bhavesh1321/g12-scissor-conveyor/SimScale/results/simscale_displacement.png

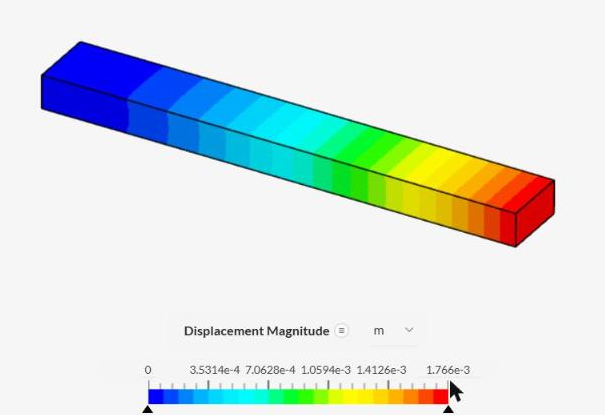
SimScale/results/simscale_displacement.png
