bhavesh1321/g12-scissor-conveyor/SimScale/results/simscale_von_mises.png

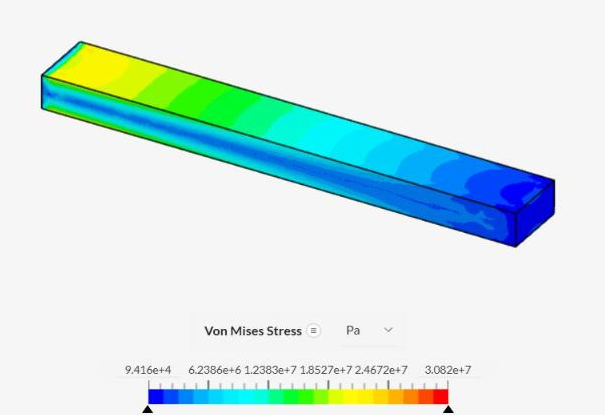
SimScale/results/simscale_von_mises.png
