bhavesh1321/g12-scissor-conveyor/Documentation/Conveyor_Project_Report_G12.docx

SCISSOR-EXPANDING BELT CONVEYOR FOR HARVEST FIELDS
(WITH MULTI-PLY AGRICULTURAL PVC CONVEYOR BELTING)

A project report submitted to

Dr. Sakthivel G

School of Mechanical Engineering

In partial fulfilment of the requirements for the course of

Agriculture Automation

In

B.Tech. Mechatronics and Automation

Group 12 | Final Project Review

Team Members:

Bhavesh A — 24BMH1048

Santhosh Kumar M — 24BMH1005

Monish K — 24BMH1001

Mithun Shankar M — 24BMH1053

Date of Submission: 21st October 2026

# ABSTRACT

This report presents the design of a scissor-expanding conveyor equipped with 2-ply food-grade agricultural PVC belting, developed to move harvested products such as banana bunches, jackfruit and coconut, each weighing up to 50 kg, from the field row to the collection vehicle. The conveyor is built as three wheeled aluminium A-frames (Head / drive, Centre, and Tail / tension) joined on each side by a lazy-tong scissor of 8 bays (16 links per side, 32 links in total) that sits on top of the A-frames. Pulling the end frames apart opens the unit to 3840 mm between end frames (4750 mm overall including the motor block) for carrying produce; pushing them together closes it to 2160 mm (3070 mm overall) for transport between fields, a change of 1680 mm or about 44 %. A flat 2-ply PVC belt with a woven polyester carcass rides on cross-beams at the scissor top nodes, so the belt stays supported at every length; this removes both the unsupported span of the earlier hinge-fold concept and the produce pinching associated with open metal mesh. The design has been taken through four CAD revisions (A to D). Revision D was rebuilt in CadQuery from the photographed prototype and passes a geometric fold check with no unintended overlaps at four bay pitches (480, 410, 340 and 270 mm). Eleven hand calculations (belt carcass and finger span, support fingers, finger beam, drive shaft, leg buckling, drive chain, scissor links and pins, and tip-over stability) all meet their criteria, but they were carried out on the revision C model and have not yet been re-run on revision D. A single plug-in worm gearmotor of at least 358 W at 26.2 rpm, fitted at the head drum, is sized to drive the full 200 kg payload. The aluminium A-frames and scissor links of the prototype are built; the belt, drive and control box are not yet fitted. Finite-element studies, the re-run of the calculations on revision D, a priced bill of materials, the load tests and the incline option remain to be done.

# INTRODUCTION

Harvesting tree and row crops such as banana, jackfruit and coconut still depends heavily on manual carrying once the produce is cut. A single bunch or fruit can weigh up to 50 kg, and carrying it by hand over even a short distance from the row to the waiting vehicle is slow, physically demanding, and a frequent cause of bruising, a problem also reported in studies of cableway-based haulage, where the hanging load swings against fixed structures along the line. A belt conveyor long enough to cover a useful span, around four metres, would remove most of this hand carrying, but a rigid conveyor of that length is awkward to move between fields and difficult to store between harvests.

This project addresses that conflict directly: the same frame needs to be long enough to be useful in the field and short enough to be convenient to move and store. The approach taken is a modular scissor-expanding architecture built from three wheeled aluminium A-frames (Head drive frame, Centre frame, and Tail tension frame). Between adjacent frames, a lazy-tong scissor on each side (4 bays per span, 8 bays and 16 links per side in total) sits on top of the A-frames, so that all eight bays open and close together as the end frames are pulled apart or pushed together. A flat, flexible multi-ply food-grade PVC belt (4 mm thick, 2-ply woven polyester carcass) rides on cross-beams at the scissor top nodes and carries the produce. Replacing open metal mesh with a continuous, smooth belt avoids bruising, skin puncture and pinching of delicate produce such as bananas and jackfruit, resists crop sap and moisture, allows washdown, and removes about 20 kg of belt tare mass (57.7 kg for the mesh against 38.0 kg for the PVC belt, on the revision C estimate). The project has been reviewed twice before; this report covers the final review and reports the concept up to revision D, the prototype built so far, and the work still pending.

# OBJECTIVES

- Change the working length of a single frame without disassembly: the conveyor must expand to 3840 mm between end frames for use in the field, and collapse to 2160 mm for moving between fields and for storage (bay pitch 480 mm to 270 mm), using the same frame and flexible PVC belt throughout.
- Carry a realistic field payload at a workable speed: the conveyor must move four items of up to 50 kg each — 200 kg total — along the belt at 0.20 m/s, with every structural and mechanical check meeting or exceeding its design criterion at that load.
- Drive the full load from a single plug-in motor: one worm gearmotor of at least 358 W at 26.2 rpm (390 W / 0.55 kW rated), fitted at the head drum, must be able to run the complete 200 kg line on its own.

# METHODOLOGY

Literature Review and Concept Generation

Existing approaches to moving harvested produce were reviewed before settling on the scissor-frame concept. A foldable conveying arm used on sugarcane harvesters (Liu H. et al., 2015) folds only for road travel and is built into the harvester, not a stand-alone unit. A review of banana post-harvest handling (Guo et al., Agronomy, 2020) covers cableway, manual and animal haulage, all of which either need a fixed line or leave the bunch swinging and exposed to bruising. A banana bunch transporter (Li et al., Agriculture, 2024) lifts and fixes a single bunch at a time rather than running a continuous belt. A patented expandable powered conveyor (Best et al., US Patent 5632371) uses lazy-tong scissor trusses to carry powered rollers, but is built for cartons riding on rollers and does not support a soft, heavy item resting between rollers. None of these gave a portable conveyor that keeps a flexible agricultural belt fully supported while the frame length itself changes by about 44 %, which is the gap this project’s concept is built to close.

CAD Modelling and Assembly

The concept went through four CAD revisions. Revisions A to C were modelled in SolidWorks (revision C as a full assembly with a motion study); revision D, the current model, was rebuilt in CadQuery (OpenCASCADE) with Python scripts and exported as STEP files, so that it matches the prototype photographed on site. The revision D model has 223 parts in the working position (215 in the fold-check model, which leaves out the belt and the other parts that are not checked) and is structured around three A-frames and a lazy-tong scissor of 8 bays per side with 620 mm links:
1. Head frame (x = 0): carries the Ø25 mm drive shaft and drum with two 36T sprockets, the plug-in worm gearmotor and coupling, and the sprocket guards.
2. Centre frame (mid-span): an A-frame that takes the load at the middle of the deck and carries the belt return supports.
3. Tail frame (end of the span): carries the tail drum and shaft, and the take-up bearings (UCT205 blocks with M16 drawbolts, 80 mm take-up travel).
Between the Head and Centre frames, and between the Centre and Tail frames, a scissor of 4 bays per side connects the span, giving 8 bays and 16 links per side (32 links in total) of Al 6082-T6 flat bar 30 × 8 mm, 620 mm between pivot pins. The scissors sit on top of the A-frames, as built. Cross-beams of RHS 80 × 40 × 3 mm at the top nodes (6 plus 1 at the centre) support the PVC belt throughout the 1680 mm stroke. The A-frame legs (splayed 6°, about 1043 mm) and lower rails are Al 6063-T5 RHS 40 × 40 × 3 mm. Smooth, closed aluminium box sections were chosen over open slotted profiles because they have no grooves to trap mud, fruit pulp or crop juice, are easy to wash down, and are stiff in bending and torsion.

Motion Study and Clash Verification

Revision C was checked with a SolidWorks motion study that drove the bay pitch from 480 mm to 270 mm and checked the assembly for interference at eight positions; it showed no clash. That model has since been replaced by revision D, which is checked geometrically instead: the revision D model is built at four bay pitches (480, 410, 340 and 270 mm) and tested for overlaps between parts, with 0 unintended overlaps at all four. This is a geometric check only; no motion study has been run on revision D.

Hand Calculations

Eleven hand calculations were carried out covering the conveyor belt carcass tensile strength and transverse finger span, the support fingers (yield and tip deflection), the finger beam (yield and deflection), leg buckling, the drive chain, the drive shaft, scissor link buckling, scissor pin shear, and tip-over stability under a lateral load. Loads were taken from the 50 kg item mass with a 1.5 impact factor (736 N per item), the revision C CAD frame and drive mass of 322.9 kg, and a belt mass of 38.0 kg (27.3 kg PVC belt sheet + 10.7 kg chain and joints), giving an overall mass of 360.9 kg. The revision C mass used simplified T-slot profiles and envelope bought-in items, so it is heavier than the revision D aluminium structure (about 46 kg from the CAD volume); the calculations are therefore kept as the governing figures until they are re-run on revision D. On that basis the finger beam (Al 6063-T5 RHS 80 × 40 × 3 mm) has a yield factor of safety of 3.98 (deflection 0.65 mm against a 1.76 mm limit) and the legs (RHS 40 × 40 × 3 mm) have a buckling factor of safety of 22.78 (against 3.0).

Drive Sizing

The belt pull, required motor power, shaft torque and chain safety factor were calculated at three payload points (empty, 100 kg and 200 kg) using a head-shaft speed of 26.2 rpm, an overall gear ratio of about 55:1, a drive efficiency of 0.57, a service factor of 1.25, and a friction coefficient of 0.35 for the fingers and return shoes. At 200 kg the maximum belt pull is 817 N, which is 163 W at the belt; dividing by the efficiency and applying the service factor gives the required motor power of 358 W. A worm gearmotor of 390 W / 0.55 kW at the head drum therefore runs the full 200 kg line with margin. The make and model are still to be confirmed.

Finite Element Study Planning

Five finite-element studies were planned in Fusion 360 to check the hand-calculated stresses in the interior block, a single support finger, the drive shaft, the conveyor belt carcass span between fingers, and a scissor link. The models and load cases were prepared on the revision C geometry (SIM1–SIM5, STEP files and a load-case JSON) and will be rebuilt on revision D before they are run.

Drawing Preparation

A seven-sheet drawing set (D01 general arrangement in the working position, D02 general arrangement in the transport position, D03 interior block detail, D04 end and motor block detail, D05 comb-finger support, D06 key parts, and D07 the bill of materials) was prepared for revision C to ISO 128 line conventions, ISO 5457 sheet sizes, ISO 7200 title blocks and an ISO 2768-mK general tolerance, and is marked as a concept set rather than issued for manufacture. The set is archived with the revision C files. It no longer matches the prototype and will be regenerated from revision D.

# IMPLEMENTATION

The design basis called for 3840 mm between end frames in the working position and 2160 mm in the transport position. The revision D model, including the motor block, measures 4750 × 1457 × 1104 mm overall in the working position and 3070 × 1457 × 1104 mm in the transport position. The key dimensions and parameters of the concept are summarised below; the load and drive figures come from the revision C hand calculations.

Parameter | Value
Working length (between end frames 3840 mm) | 4750 mm overall, including the motor block
Transport length (between end frames 2160 mm) | 3070 mm overall, including the motor block
Bay pitch — working / transport | 480 mm / 270 mm
Support frames / scissor bays | 3 wheeled A-frames (Head, Centre, Tail) / 8 bays per side (4 per span), 32 links in total
Scissor link length | 620 mm
Aluminium structure mass (rev D CAD volume) | about 45.9 kg; total mass TBC
Belt mass (rev C estimate) | 38.0 kg (27.3 kg 2-ply PVC sheet + 10.7 kg chain/joints)
Total mass used in rev C hand calcs | 360.9 kg (frame and drive 322.9 kg, simplified rev C CAD)
Wheels | 6 × Ø125 mm wheels on Ø16 mm cross axles (2 per A-frame); static rating ≥ 141 kg each assumed, part TBC
Payload capacity | 4 items, 200 kg, 0.20 m/s
Motor requirement (head drum) | ≥ 358 W (390 W / 0.55 kW rated), 26.2 rpm, worm gearmotor
Overall gear ratio / drive efficiency / service factor | ≈ 55:1 / 0.57 / 1.25
Overall width / height | 1457 mm / 1104 mm in both positions (rev D CAD)
Deck height (working position) | 900 mm, level; incline option open

Concept Evolution: Revision A to Revision C

The first concept (revision A) folded the frame at a central hinge with the belt fitted. This left the belt unsupported across a 396 mm span at the fold and, when folded, stood 2.7 m tall, which was too tall to be practical; these were flagged as open items OI-14 and OI-19 at the first review. Both issues were resolved by moving to a lazy-tong scissor frame: the belt is carried on cross-beams at the top nodes, so there is no unsupported span at any length, and because the frame changes mainly in length and not in height, the transport configuration stays at about 1.1 m (1104 mm). Revision C modelled the scissor with comb fingers and castors. Revision D, the current model, was rebuilt from the photograph of the built prototype: three A-frames with the scissors on top and a flat PVC belt on cross-beams, replacing the earlier placement of the scissors and supports.

Scissor Travel Verification

The scissor connects the three A-frames through two 4-bay spans (16 links per side, 32 links in total, 620 mm between pins). The bays share their sliding joints, so all of them open and close together when the end frames are pulled apart or pushed together. Between the working and transport positions the bay pitch changes from 480 mm to 270 mm, and the length between end frames from 3840 mm to 2160 mm, a travel of 1680 mm (44 %); the overall length including the motor block goes from 4750 mm to 3070 mm. The revision D fold check at four pitches (480, 410, 340 and 270 mm) found 0 unintended overlaps. The earlier SolidWorks motion study of revision C (8 seconds of simulated travel, eight positions, no clash) supports the same behaviour. The belt has to be unpinned and rolled before the frame is closed.

Drive Power Calculation

Belt pull, motor power, shaft torque and chain safety factor were calculated at three payload points, shown below. The chain safety factor criterion is 8.0; at the full 200 kg payload the stainless chain comes out at 9.68. A single worm gearmotor of at least 358 W (390 W / 0.55 kW rated) at the head drum covers the full line. These are revision C figures, to be re-run on revision D.

Payload (kg) | Belt pull (N) | Motor min. (W) | Shaft torque (N·m) | Chain SF (stainless)
0 | 130 | 57 | 9.5 | 34.9
100 | 474 | 208 | 34.5 | 15.2
200 | 817 | 358 | 59.5 | 9.68

Conveyor Belt Carcass and Support Finger Check

The 2-ply agricultural food-grade PVC conveyor belt is supported by cross-beams at the scissor top nodes. In the revision C hand calculation it spans a 34 mm gap between adjacent comb fingers. Unlike open metal wire mesh, which can bruise produce and was limited by bending of the 3.5 mm cross-rods (a tight FoS of 2.10 in earlier revisions), the 4 mm PVC belt has a high-tenacity woven polyester (EP) carcass with a nominal breaking strength of 160 N/mm width (121.3 kN across the 758 mm belt width) and an allowable continuous working tension of 16 N/mm (12.1 kN). Under the 736 N factored item load, the produce contact footprint (305 × 305 mm) spreads across 6 finger lanes, giving a contact pressure of only 7.9 kPa. The tensile factor of safety is 17.0 against the working rating, and the transverse carcass deflection across the 34 mm span is under 0.1 mm. The support fingers carry ample margin: the worst-case overhang gives a yield factor of safety of 5.60 and a tip deflection of 0.62 mm against a 0.68 mm limit. The belt make and rating are still to be confirmed with a supplier.

Wheel Selection and Ground Support

The prototype rolls on six Ø125 mm wheels on cross axles (Ø16 mm), two under each A-frame. Concentrating the ground support under the three A-frames gives a stable three-point contact on uneven field soil and avoids the wheel-wobble and over-constraint of a many-castor layout. The revision C hand calculation sized the wheels from the worst-case placement of a single 50 kg item (with 1.5 impact) on one corner leg plus dead load, which needs a static rating of about 139 kg per wheel (a 141 kg rating was assumed). With six wheels the total static capacity is 846 kg against 560.9 kg for the machine with the full 200 kg payload (360.9 kg + 200 kg), an average of 93.5 kg per wheel and a ratio of 1.51. Whether the final wheels are braked swivel castors, and their catalogue part and rating, are still to be confirmed. Compared with an 18-castor layout, six wheels save about 11.3 kg of tare mass (16.9 kg down to 5.6 kg).

Finite Element Studies

Five Fusion 360 studies are planned against the hand-calc results, to be accepted if the finite-element result comes within about 15 % of the hand calculation, or if any larger difference can be explained by the conservative assumptions in the hand calc (such as treating the full item load as resting on three fingers, or on a single beam). None of the five studies has been run.

Study | Model | Hand-calc target | Fusion result
SIM1 | One interior block, item centred / on tips | Beam stress 27.6 MPa | Pending
SIM2 | Finger, 14 × 20 cantilever | Root stress 44.7 MPa | Pending
SIM3 | Drive shaft, Ø25, start torque | Von Mises 74.2 MPa | Pending
SIM4 | Conveyor belt carcass, 2-ply PVC on 34 mm span (rev C) | Pressure 7.9 kPa (FoS 17.0) | Pending
SIM5 | Link 30 × 8, 620 mm pins | Buckling factor 6.16 | Pending

The frame’s own self-weight (about 170 N axial per leg) is left out of these preview studies and will be added once the first results are available.

# RESULTS AND ANALYSIS

All eleven hand-calculated checks pass against their design criteria on the revision C mass of 360.9 kg (reduced from 380.6 kg by the 2-ply PVC belt), summarised below. They have not yet been re-run on revision D.

Check | Value | Criterion | Status
Conveyor belt carcass tensile & span FoS (2-ply PVC) | 17.0 | ≥ 2.0 | PASS
Support finger yield FoS (worst overhang) | 5.60 | ≥ 2.0 | PASS
Support finger tip deflection | 0.62 mm | ≤ 0.68 mm | PASS
Finger beam yield FoS | 3.98 | ≥ 2.0 | PASS
Finger beam deflection | 0.65 mm | ≤ 1.76 mm | PASS
Leg buckling FoS (K = 2) | 22.78 | ≥ 3.0 | PASS
Chain SF, stainless, 200 kg (one motor) | 9.68 | ≥ 8.0 | PASS
Drive shaft Ø25 yield FoS (start) | 4.43 | ≥ 2.0 | PASS
Scissor link buckling FoS (10% W push) | 6.38 | ≥ 3.0 | PASS
Scissor pin shear FoS | 57.39 | ≥ 3.0 | PASS
Tip-over SF (lateral 10% W) | 4.89 | ≥ 1.5 | PASS

The kinematic side is supported by the CAD checks: the frame closes from 3840 mm to 2160 mm between end frames (4750 mm to 3070 mm overall), a travel of 1680 mm or 44 %, with 0 unintended overlaps in the revision D fold check at four bay pitches and no clash in the earlier revision C motion study, so long as the belt is unpinned and rolled before the frame is closed. The drive-sizing results show that a single worm gearmotor of at least 358 W (comfortably met by a standard 390 W / 0.55 kW unit) is enough to run the whole line, with the chain safety factor at 9.68 against the 8.0 criterion. The structural side has two open items: the five finite-element studies have not been run, and the hand calculations have not been repeated on revision D, so the revision C figures above remain the governing numbers for now.

# DISCUSSION

Achievement of Objectives

All three stated objectives have been met at the design level, but not yet demonstrated on the prototype. The frame changes length on its own, between 3840 mm working and 2160 mm transport between end frames, without any disassembly, as shown by the CAD fold check. The structure and drive are sized for the full four-item, 200 kg payload at 0.20 m/s, with every hand-calculated check passing its criterion on revision C. A single motor at the head drum is sized to drive that full load. The belt, drive and control box are not yet fitted to the prototype, and no load or fold test has been run.

Performance and Results Interpretation

In the earlier concept with wire mesh, the tightest check was the mesh cross-rod at a factor of safety of 2.10 against a criterion of 2.0 (only 5 % margin), which also risked bruising the crop. Replacing the metal mesh with 2-ply agricultural food-grade PVC belting removes this weakness: the polyester carcass gives a tensile factor of safety of 17.0 with negligible deflection. Every other check carries a substantial margin: support finger yield FoS 5.60, finger beam yield 3.98, drive shaft yield 4.43, chain SF 9.68, and leg buckling and pin shear well above 20. These margins come from the revision C model and need to be confirmed on revision D.

Mechanical Enhancements

Moving from the revision A hinge-fold to a scissor frame removed both problems flagged at the first review. Three A-frames joined by an 8-bay scissor on each side, with the belt carried on cross-beams at the top nodes, eliminated the unsupported span that made the fold unreliable under load. Changing length instead of folding height kept the transport height at about 1.1 m instead of the 2.7 m the folded concept needed, which matters directly for how the unit is moved and stored between fields. Replacing the wire mesh with agricultural PVC belting gives a washable, smooth surface that avoids bruising soft produce and lowers the belt tare mass by about 19.7 kg. Using closed aluminium box sections (Al 6063-T5 RHS 80 × 40 × 3 mm for beams, RHS 40 × 40 × 3 mm for legs and rails) gives a slot-free frame that does not trap dirt, pulp or crop sap and is easy to wash down. Ground support is six wheels under the three A-frames, which cuts rolling drag and dead weight.

Challenges Faced

The main challenge through revisions A to D was finding a way to change the frame’s length substantially (by about 44 %) without either leaving gaps in the belt support or making the folded unit too tall to move easily; the two requirements pulled in different directions until the lazy-tong scissor was adopted. A second challenge was that the revision C CAD placed the scissors and supports differently from the prototype that was actually built, so revision D was rebuilt as A-frames with the scissors on top, working from the prototype photograph. A third, in earlier iterations, was sizing the wire mesh rod tightly enough to balance weight against bending safety; replacing the mesh with 2-ply PVC belting removed that problem.

Solutions and Refinements

The scissor of 8 bays per side, with sliding joints shared by the bays, solved the length-change problem directly, letting all bays open and close together when the end frames are moved and lock at either end. Carrying the belt on cross-beams at the top nodes solved the belt-support problem at every length. The decision on whether the deck should stay level or be made to incline remains open: the design basis allows a deck height anywhere from 350 to 1200 mm, while the current concept is level at 900 mm in the working position. Telescopic legs are the proposed way to add an incline, and the decision will be settled before the drawings are finalised for manufacture.

# CONCLUSION

By this review, the scissor-expanding conveyor with agricultural PVC belting has reached a revision D concept that matches the built prototype: three wheeled aluminium A-frames joined by an 8-bay lazy-tong scissor on each side, with a flat PVC belt carried on cross-beams at the top nodes. The CAD closes from 3840 mm to 2160 mm between end frames (4750 mm to 3070 mm overall) with 0 unintended overlaps at four bay pitches, and eleven hand calculations on revision C all meet their criteria at the 200 kg payload. A single plug-in worm gearmotor of at least 358 W (390 W / 0.55 kW rated) at the head drum is sized to drive the complete line. The design has met its three stated objectives at the concept level. What remains is the re-run of the hand calculations on revision D, the finite-element verification of five critical components, confirmation of the supplier-dependent items (PVC belt, chain rating, wheels, gearmotor), regenerating the drawing set for revision D, the level-versus-incline decision, fitting the belt, drive and control box to the prototype, and the load and fold tests.

# FUTURE WORK

- Re-run the hand calculations on revision D, then run the five Fusion 360 studies (SIM1–SIM5) on the revision D geometry and fill in the hand-calc-versus-FEA comparison, including the frame self-weight left out of the current preview models.
- Confirm the supplier-dependent items (stainless chain UTS, 2-ply PVC conveyor belt specification of 4 mm thickness and 160 N/mm tensile rating, wheel or castor part rated for at least 141 kg static load, and the gearmotor make and model) and re-check the affected calculations against the confirmed figures.
- Decide between the level deck (current concept, 900 mm) and an inclined deck (350–1200 mm per the design basis, using telescopic legs), and update the model accordingly.
- Fit the belt, drive and control box to the prototype, then load-test one belt section and the fold action to check the lock hold and the finger and beam deflection under a realistic item load.
- Resolve the open question on driving the conveyor from both end blocks at once, which would need a master/slave drive arrangement rather than the single-motor case covered so far.
- Price the bill of materials once the supplier-dependent items are confirmed; the revision D aluminium structure is about 46 kg (CAD volume), but the total mass and a cost figure are not yet available.

Carrying this work out needs workshop time to fit the belt and drive, aluminium rectangular hollow box stock (RHS 80 × 40 × 3 and 40 × 40 × 3, Al 6063-T5) for any further frames, and lab computer time to run the five Fusion 360 studies. These are the support required to close out the remaining open items.

# REFERENCES

- H. Liu et al., Foldable conveying arm for a cane harvester, Sugar Cane Industries, no. 3, pp. 50–58, 2015.
- Guo et al., “Mechanized technology research and equipment application of banana post-harvesting: a review,” Agronomy, vol. 10, no. 3, art. 374, 2020. doi:10.3390/agronomy10030374.
- W. Li et al., “Design and experimental study of banana bunch transportation device with lifting mechanism and automatic bottom-fixing fruit shaft,” Agriculture, vol. 14, no. 7, art. 1161, 2024. doi:10.3390/agriculture14071161.
- J. W. Best, G. D. Carter, B. K. Flippo and J. D. Walker, “Expandable redundantly powered conveyors,” US Patent 5 632 371, 27 May 1997.
- ISO 128: Technical drawings — General principles of presentation.
- ISO 5457: Technical product documentation — Sizes and layout of drawing sheets.
- ISO 7200: Technical product documentation — Data fields in title blocks.
- ISO 2768-mK: General tolerances for linear and angular dimensions, and for form and position, without individual tolerance indications.
