bhavesh1321/g12-scissor-conveyor/Documentation/Faculty_Messages/WhatsApp Image 2026-11-05 at 3.39.30 PM.jpeg

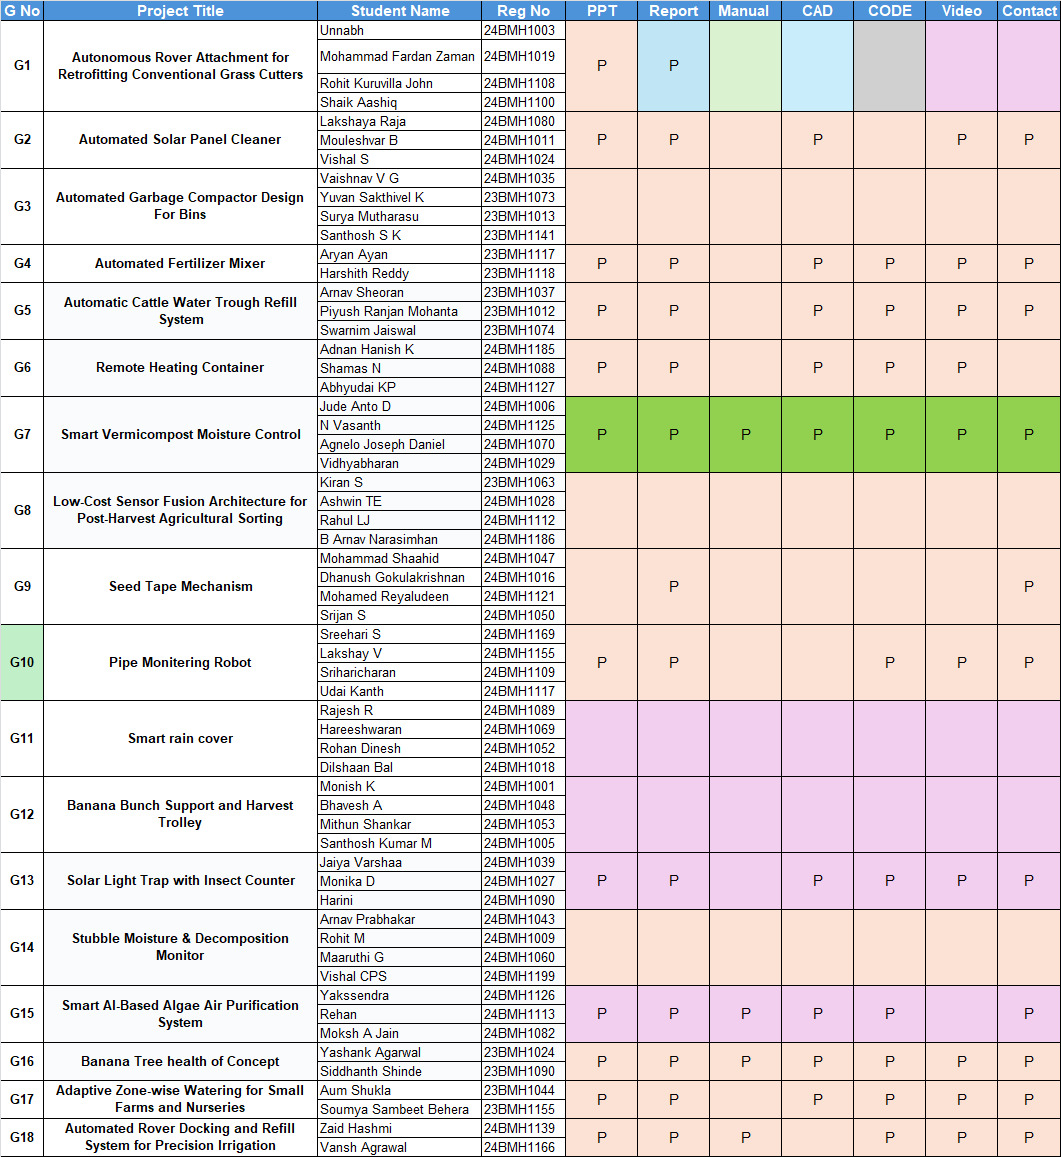
Documentation/Faculty_Messages/WhatsApp Image 2026-11-05 at 3.39.30 PM.jpeg
