bhavesh1321/g12-scissor-conveyor/Documentation/Figures/proto_full.jpg

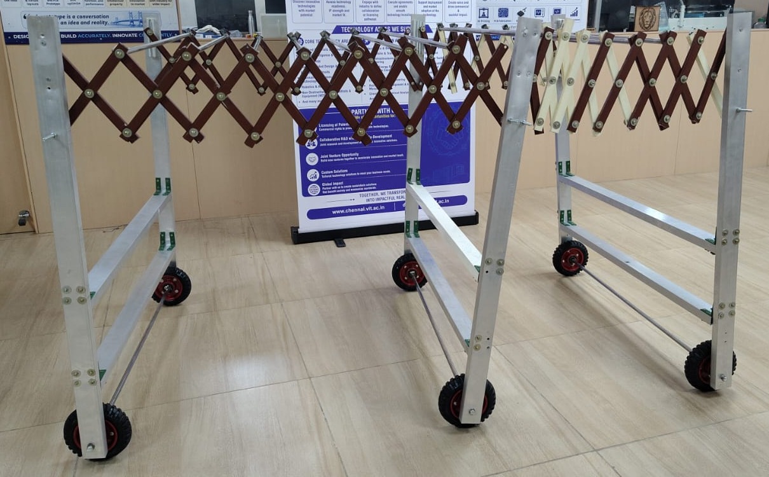
Documentation/Figures/proto_full.jpg
