bhavesh1321/g12-scissor-conveyor/Documentation/Figures/proto_scissor.jpg

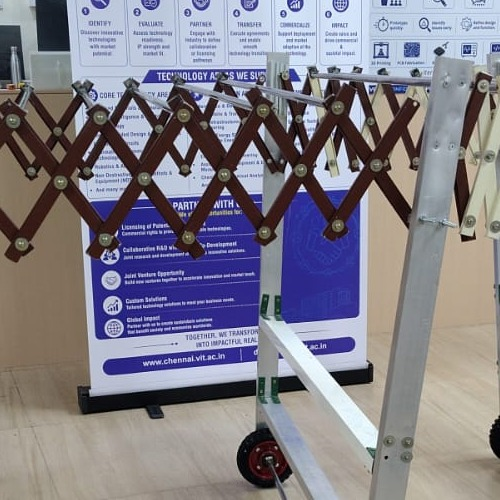
Documentation/Figures/proto_scissor.jpg
