bhavesh1321/g12-scissor-conveyor/Documentation/Review3_Submission/WhatsApp Image 2026-10-26 at 8.19.39 PM.jpeg

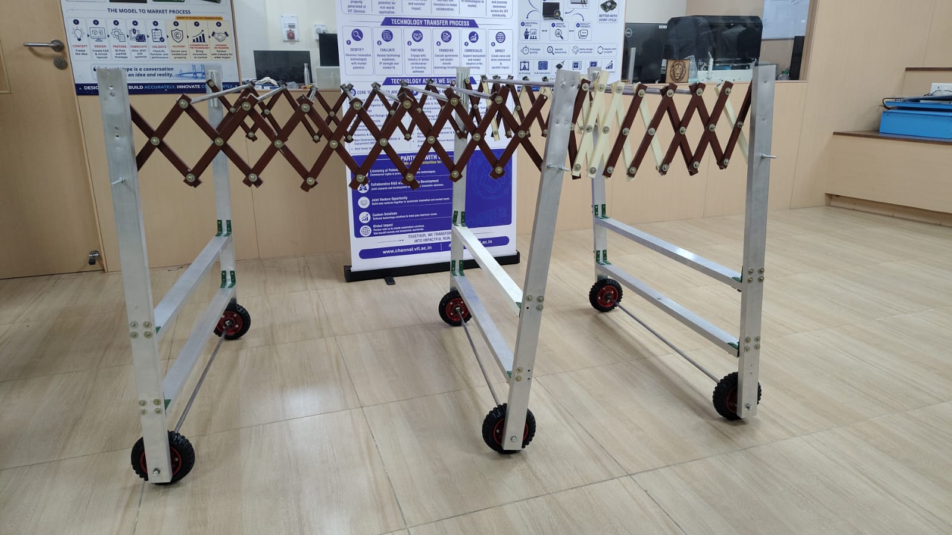
Documentation/Review3_Submission/WhatsApp Image 2026-10-26 at 8.19.39 PM.jpeg
