bhavesh1321/g12-scissor-conveyor/references/WhatsApp Image 2026-11-05 at 6.08.54 PM.jpeg

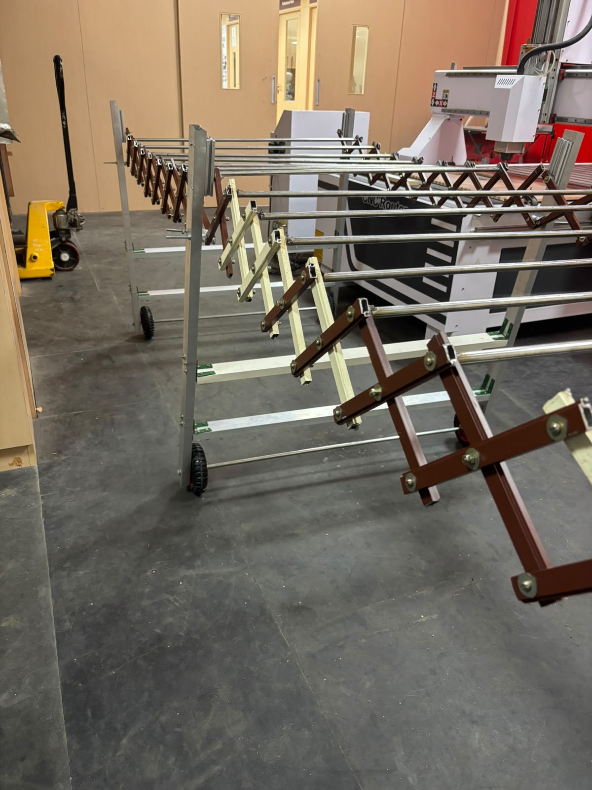
references/WhatsApp Image 2026-11-05 at 6.08.54 PM.jpeg
