bhavesh1321/g12-scissor-conveyor/references/Agri project.xlsx

 | MONISH | BHAVESH | SANTHOSH KUMAR | MITHUN SHANKAR
COMPONENT | Miscellaneous | Steel rod |  | Aluminium extrusion(links)
AMOUNT | 200 | 3600 |  | 3884
COMPONENT |  | Aluminium Profile and T nuts |  | Aluminium extrusion(structure)
AMOUNT |  | 1074 |  | 1750
COMPONENT |  | Fasteners |  | Fastener
AMOUNT |  | 600 |  | 937
COMPONENT |  |  |  | Chain, Sprocket, Hub
AMOUNT |  |  |  | 2640
COMPONENT |  |  |  | Belt
AMOUNT |  |  |  | 9000
COMPONENT |  |  |  | Miscellaneous
AMOUNT |  |  |  | 400
TOTAL: 24085
Per Person Total: 6021
