bhavesh1321/g12-scissor-conveyor/CAD/G12_Extendable_Conveyor_Full_Assembly.step

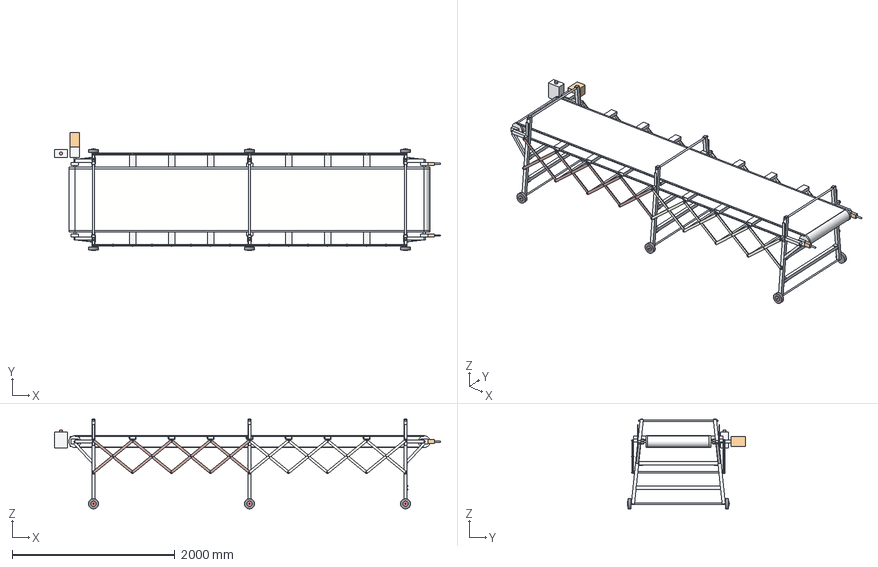
[picture p50: CAD file, 2026-11-08]
CAD/G12_Extendable_Conveyor_Full_Assembly.step
4750.0 x 1456.7 x 1104.0 mm
