bhavesh1321/g12-scissor-conveyor/SimScale/geometry/cross_beam_half_L568.step

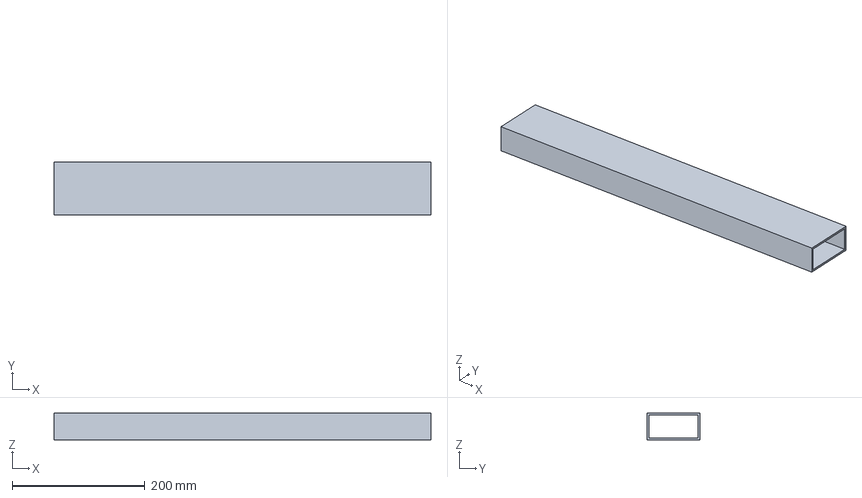
[picture p51: CAD file, 2026-11-08]
SimScale/geometry/cross_beam_half_L568.step
568.0 x 80.0 x 40.0 mm
