bhavesh1321/g12-scissor-conveyor/SimScale/geometry/cross_beam_RHS80x40x3_L1136.step

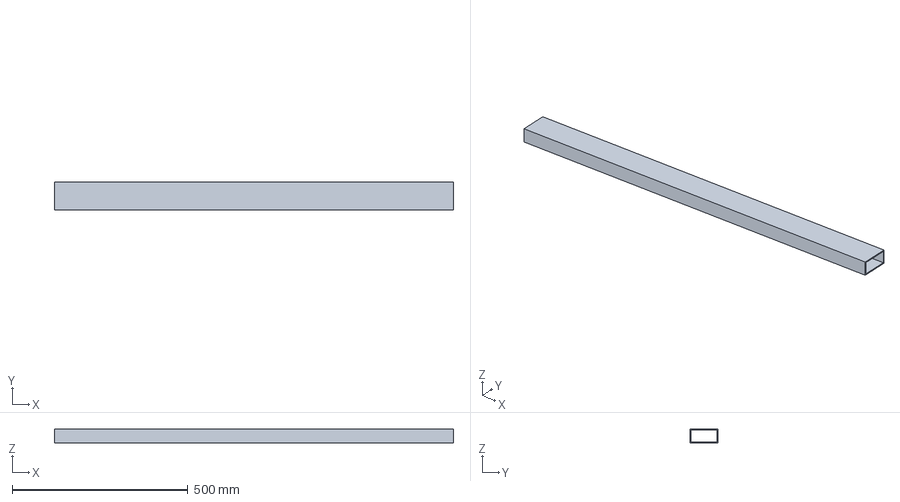
[picture p52: CAD file, 2026-11-08]
SimScale/geometry/cross_beam_RHS80x40x3_L1136.step
1136.0 x 80.0 x 40.0 mm
