bhavesh1321/g12-scissor-conveyor/SimScale/geometry/scissor_link_30x8x620.step

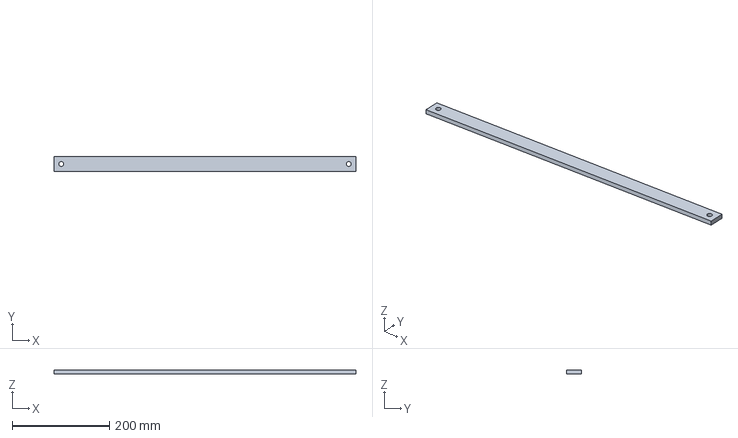
[picture p53: CAD file, 2026-11-08]
SimScale/geometry/scissor_link_30x8x620.step
620.0 x 30.0 x 8.00 mm
