bhavesh1321/g12-scissor-conveyor/Documentation/Faculty_Messages/No need to send the manual.txt

No need to send the manual
Send the PPT and the video in the given format and rest of the files via email
