bhavesh1321/g12-scissor-conveyor/Documentation/Review3_Submission/FINAL DRAFTING.pdf

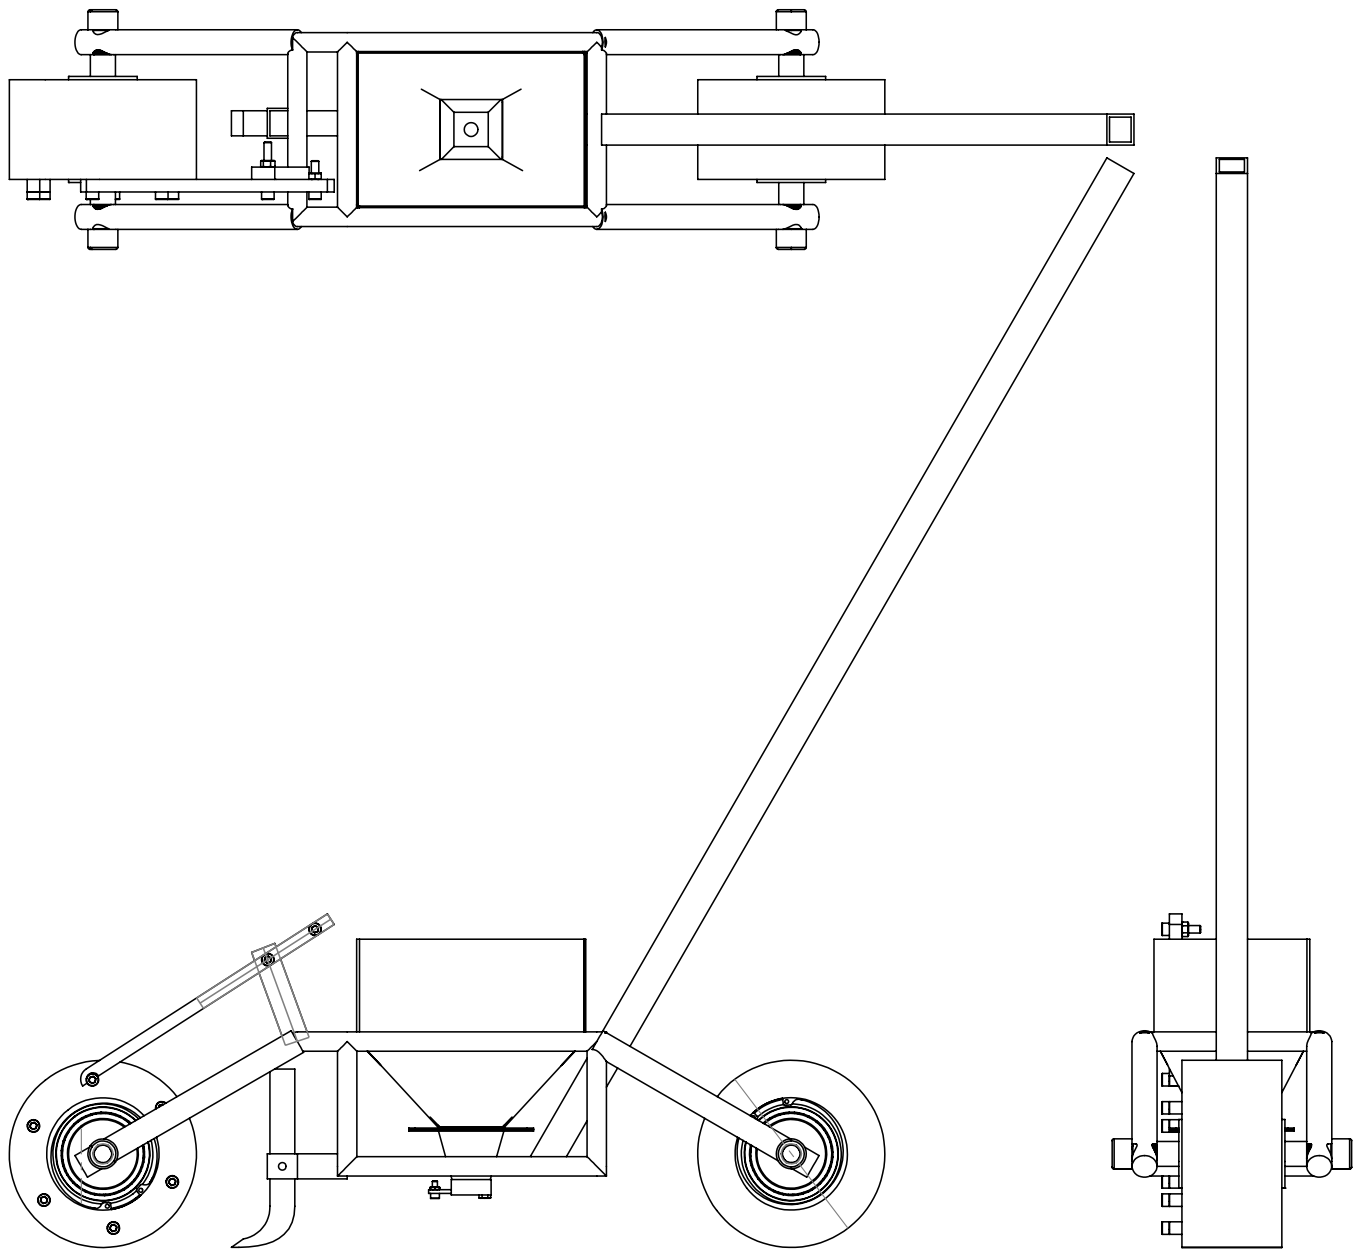
[picture p55: page 1]

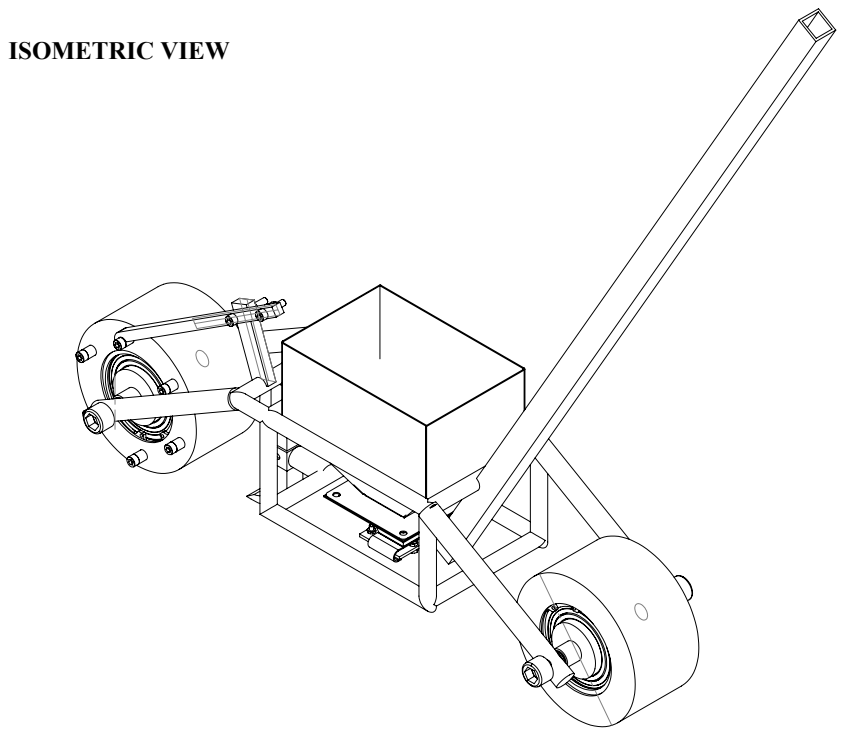
[picture p56: page 2]
ISOMETRIC VIEW

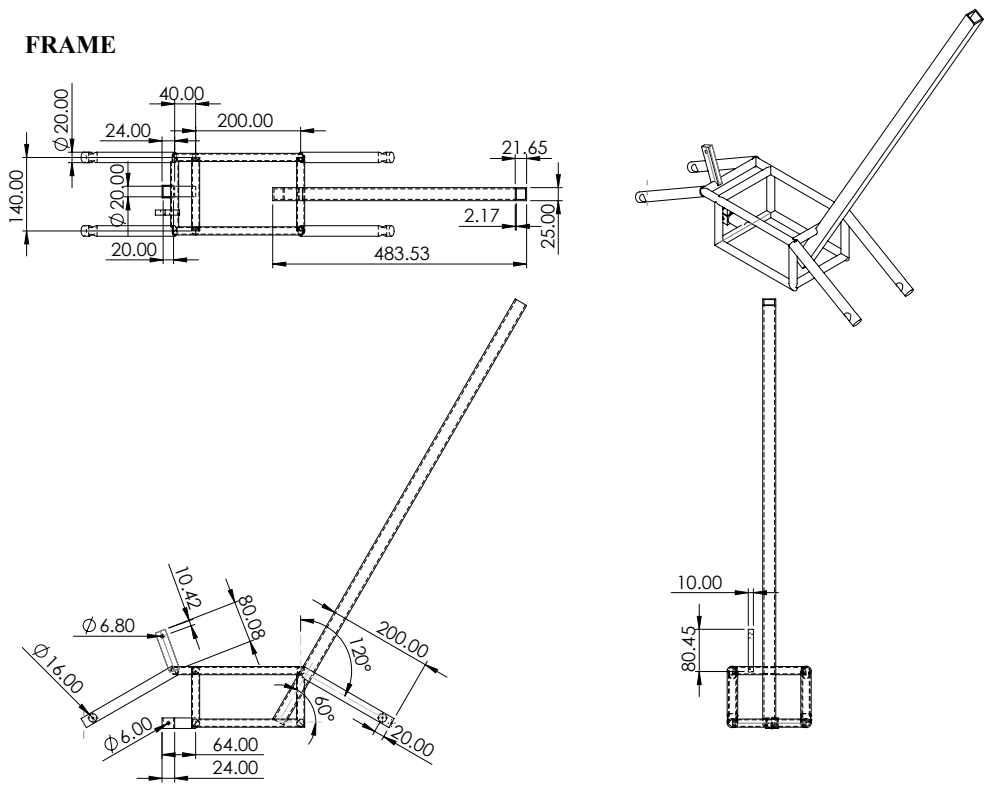
[picture p57: page 3]

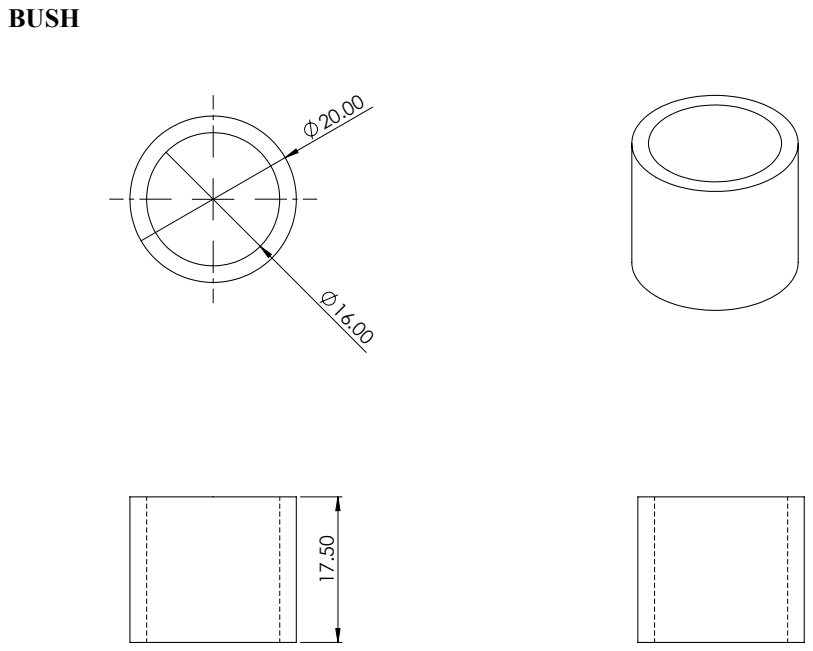
[picture p58: page 4]

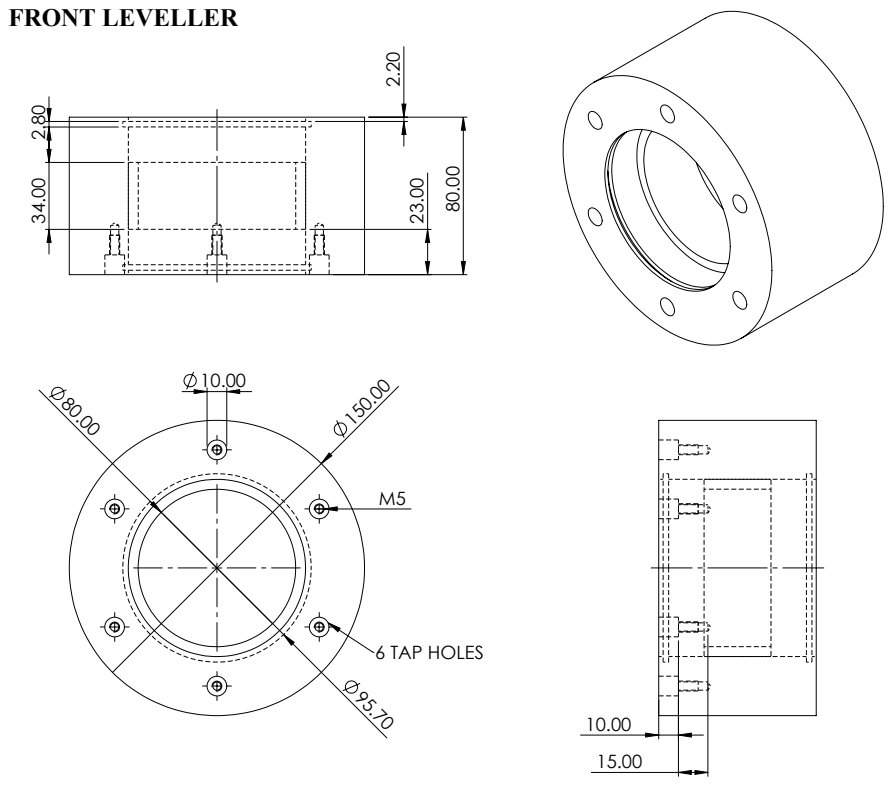
[picture p59: page 5]
6 TAP HOLES; FRONT LEVELLER

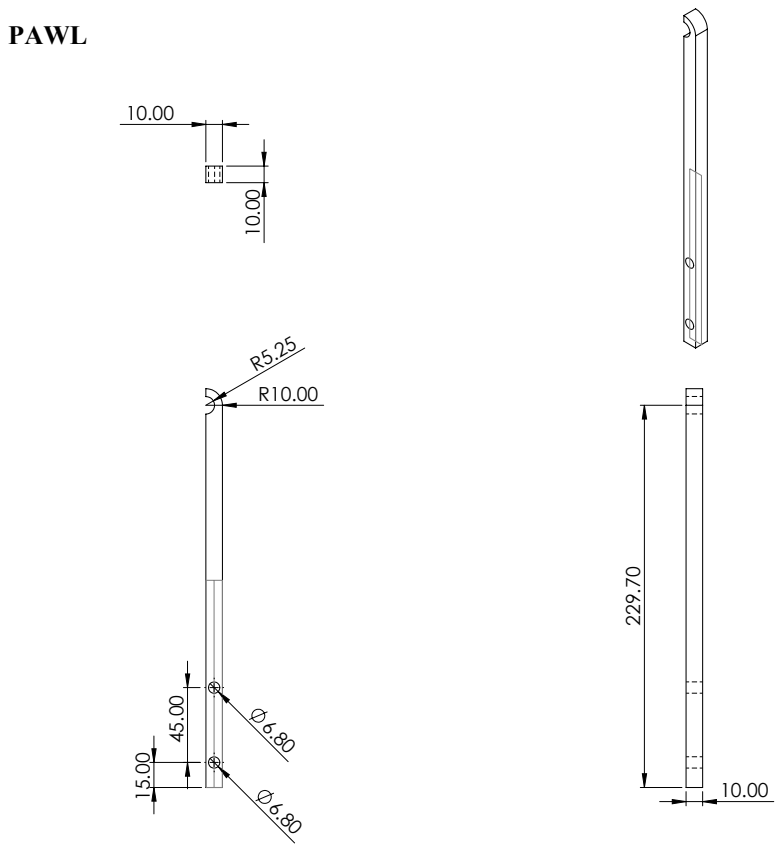
[picture p60: page 6]

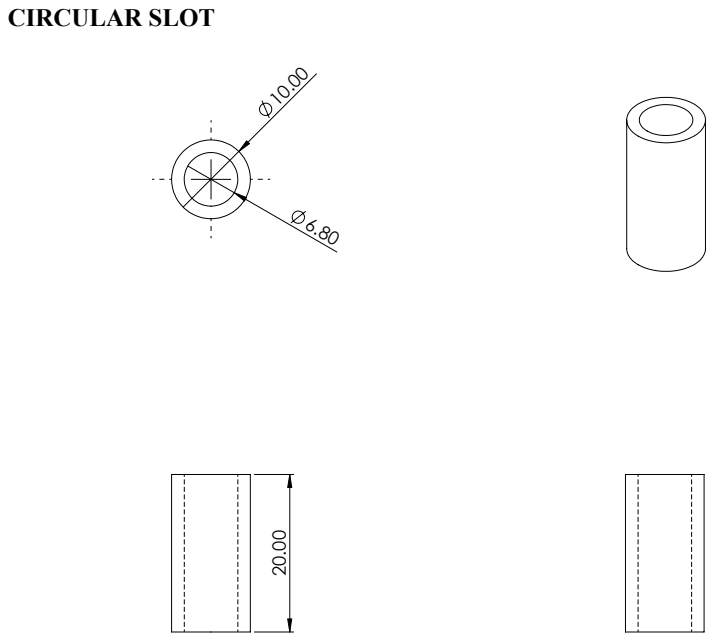
[picture p61: page 7]
CIRCULAR SLOT

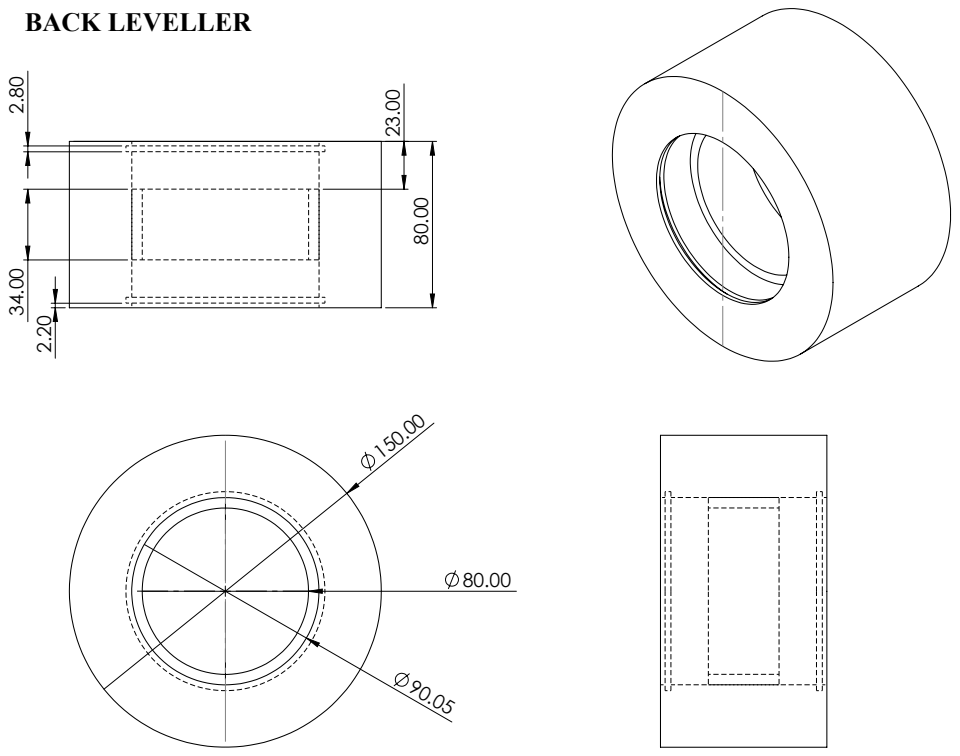
[picture p62: page 8]
BACK LEVELLER

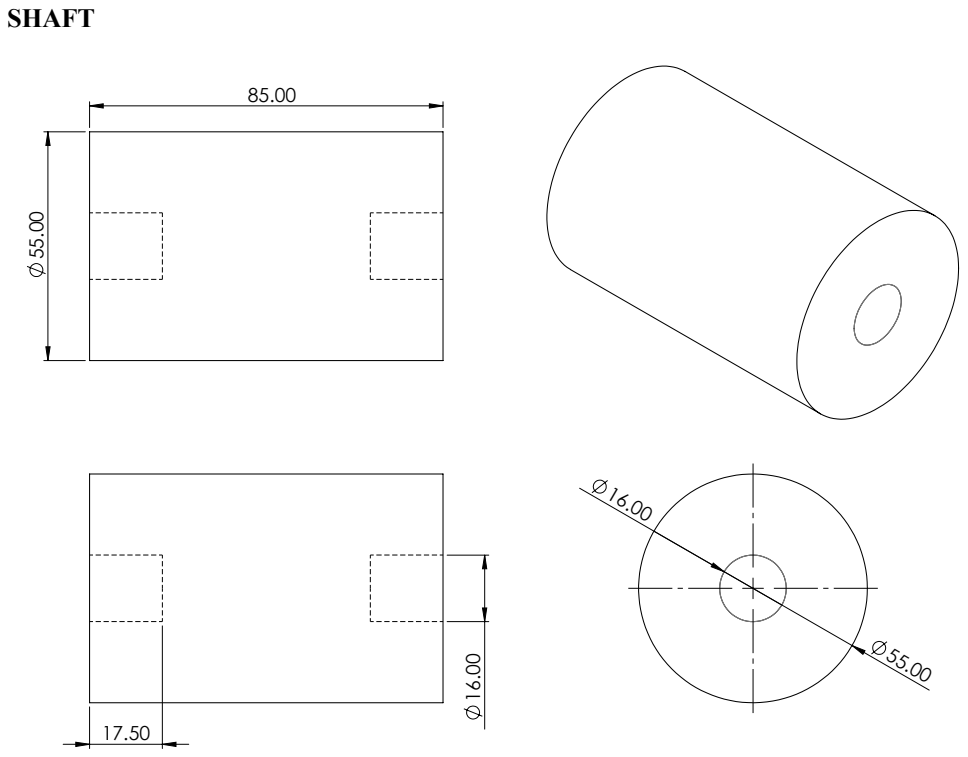
[picture p63: page 9]

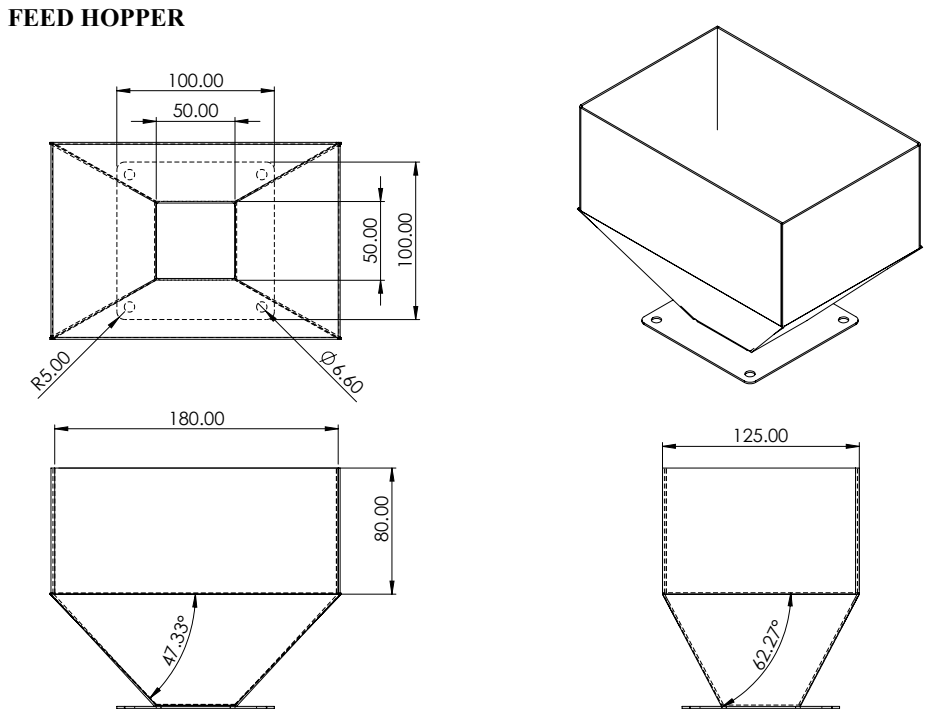
[picture p64: page 10]
FEED HOPPER

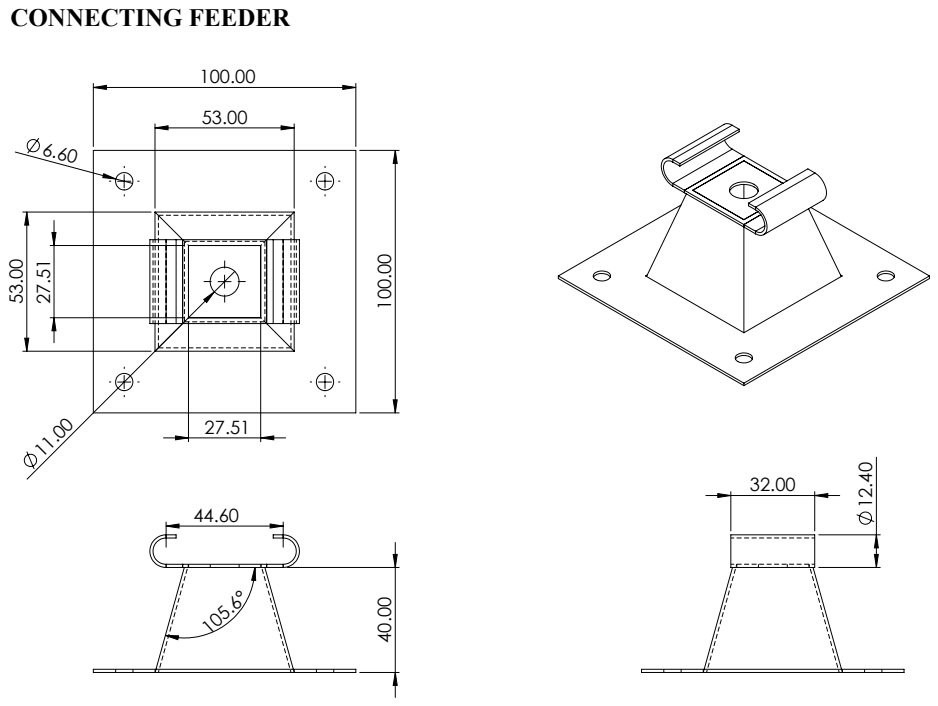
[picture p65: page 11]
CONNECTING FEEDER

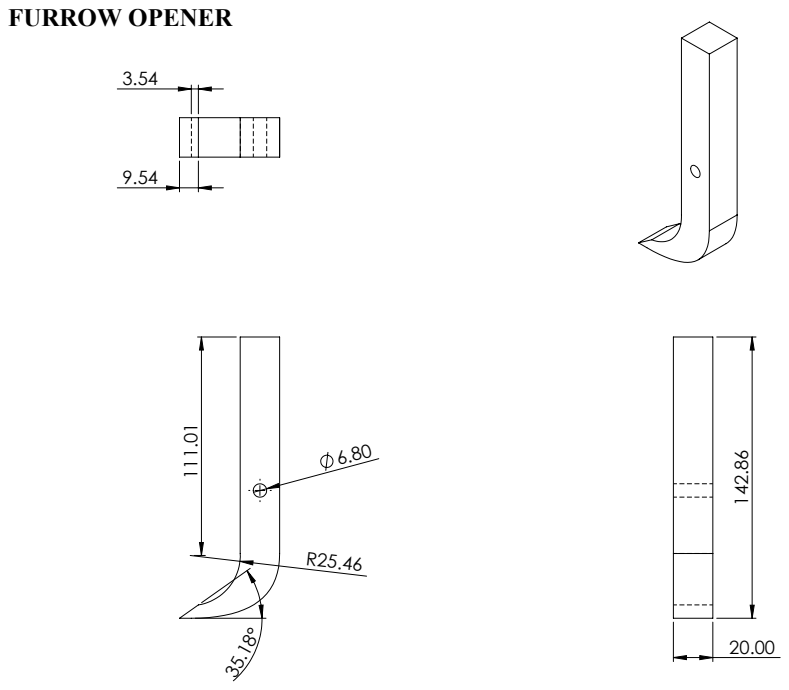
[picture p66: page 12]
FURROW OPENER

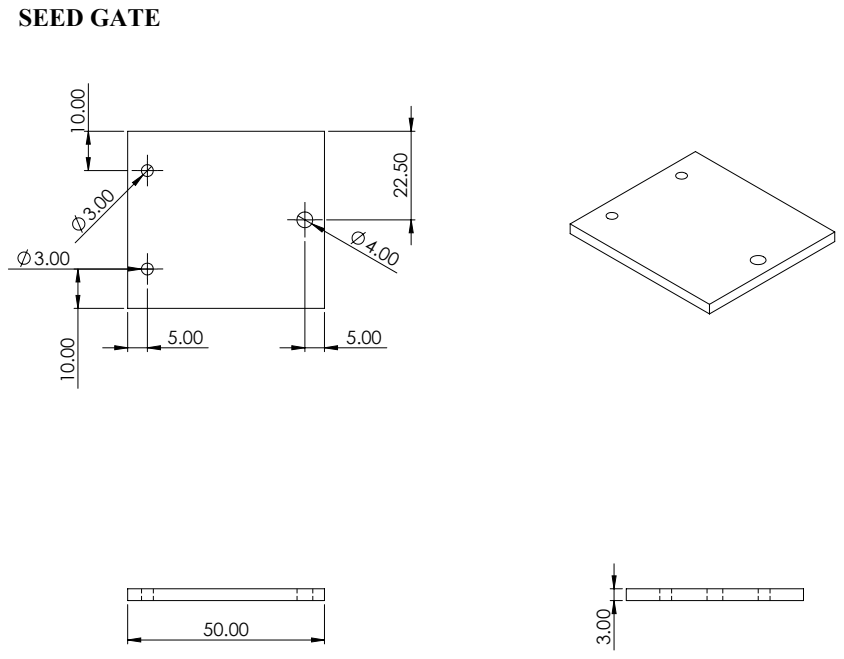
[picture p67: page 13]
SEED GATE
