bhavesh1321/g12-scissor-conveyor/(commit log)

2026-10-29 G12 scissor-expanding conveyor: rev D CAD and documentation
    [G12_revD_transport.step, G12_revD_working.step, Third_Project_Review_Schedule.xlsx]
2026-11-08 Reorganize repo: keep human-made files, add new full-assembly CAD
    - Replace old rev D CAD and renders with G12 Extendable Conveyor Full Assembly.step
    - Remove script-generated simulation, video and deck files
    - Add SimScale geometry and results
    - Group faculty messages under Documentation, add README
    [Agri project.xlsx, G12_Extendable_Conveyor_Full_Assembly.step, G12_revD_transport.step, G12_revD_working.step, cross_beam_RHS80x40x3_L1136.step, cross_beam_half_L568.step, cross_beam_half_L568_caps.step, scissor_link_30x8x620.step]
